Annnnya/talos_hack/CAD/CAD renders/Render1/images/panorama.png

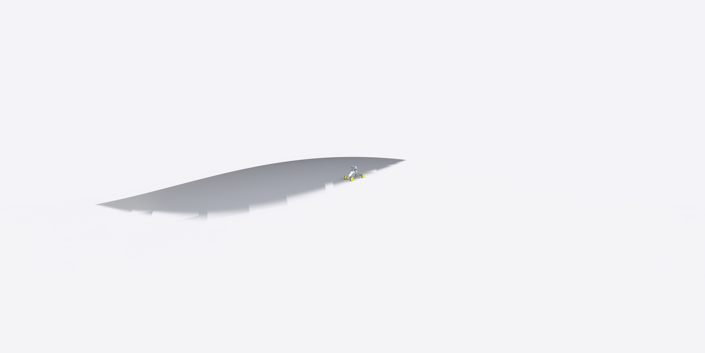
CAD/CAD renders/Render1/images/panorama.png
