Annnnya/talos_hack/CAD/CAD renders/render2.png

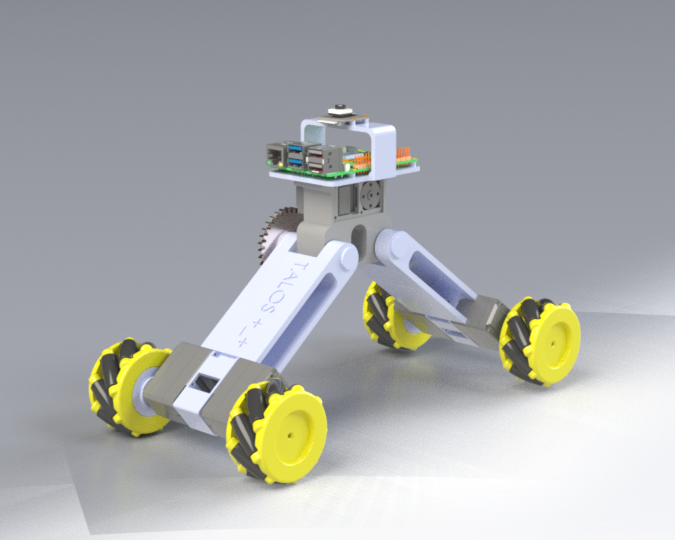
CAD/CAD renders/render2.png
