Annnnya/talos_hack/CAD/roue Mecanum.stp

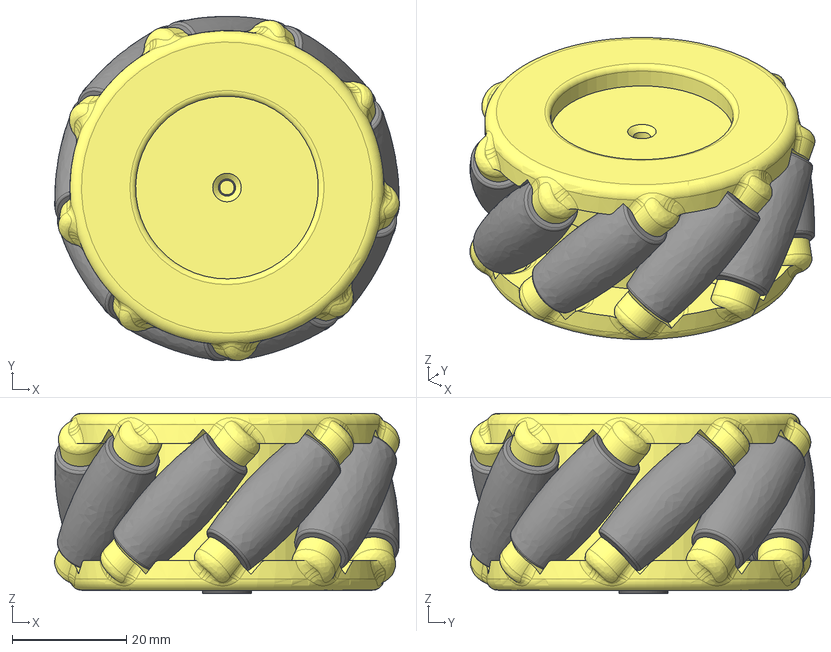
[picture p4: CAD file, 2026-10-20]
CAD/roue Mecanum.stp
60.4 x 60.3 x 31.6 mm
axes galet
galet x 9
adaptateur axe
axes galet flasque-01-02
axes galet flasque-01-01
