Annnnya/talos_hack/CAD/motor mounts.STEP

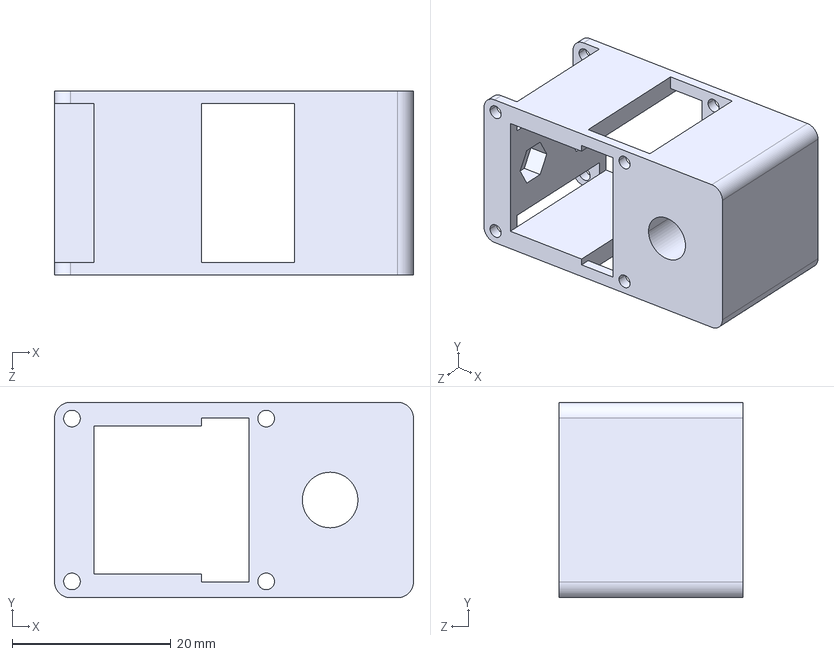
[picture p5: CAD file, 2026-10-20]
CAD/motor mounts.STEP
45.2 x 24.6 x 23.2 mm
