Annnnya/talos_hack/CAD/rpi mount.SLDPRT

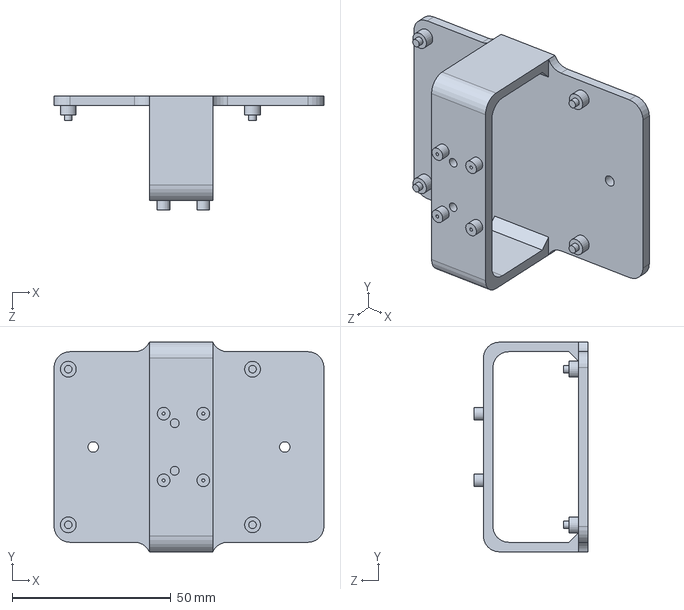
[picture p6: CAD file, 2026-10-20]
CAD/rpi mount.SLDPRT
85.0 x 66.0 x 36.0 mm
