Annnnya/talos_hack/CAD/spur gear.SLDPRT

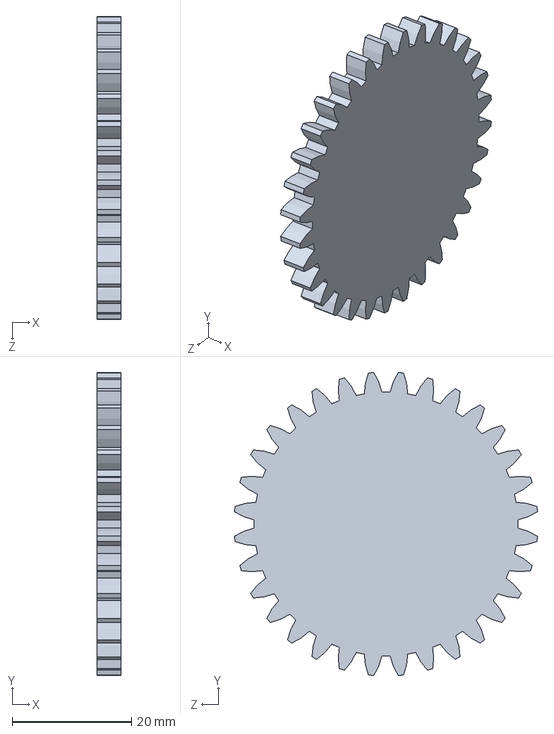
[picture p7: CAD file, 2026-10-20]
CAD/spur gear.SLDPRT
4.00 x 50.8 x 50.8 mm
