Annnnya/talos_hack/CAD/front plate.SLDPRT

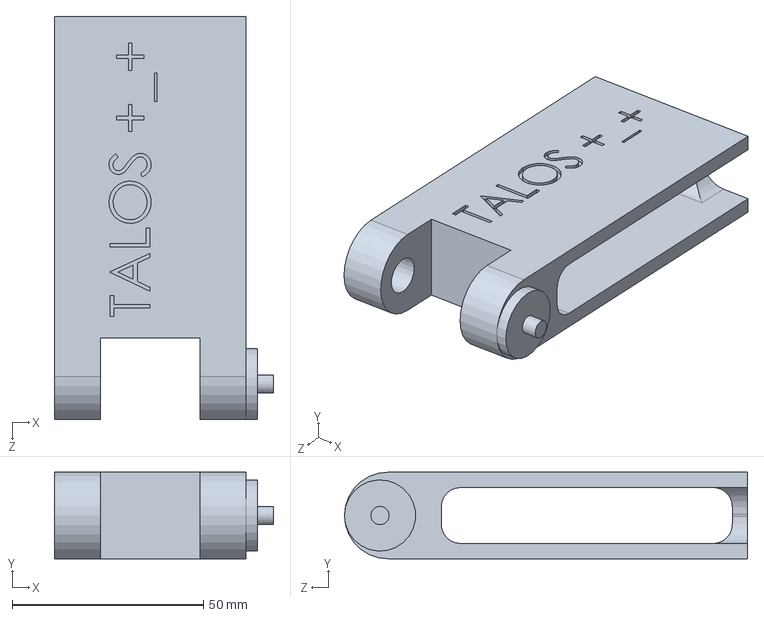
[picture p8: CAD file, 2026-10-20]
CAD/front plate.SLDPRT
57.2 x 22.6 x 105.3 mm
