Annnnya/talos_hack/CAD/Servo_enclosure_Servo_Enclosure.SLDPRT

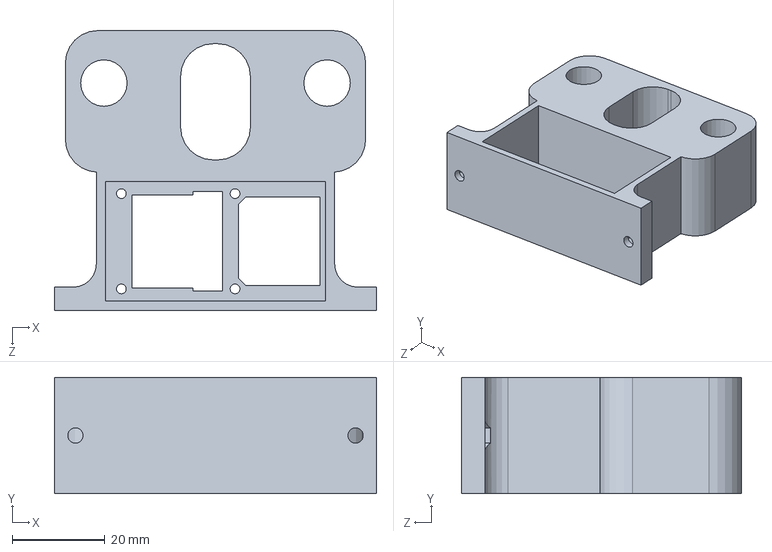
[picture p9: CAD file, 2026-10-20]
CAD/Servo_enclosure_Servo_Enclosure.SLDPRT
69.3 x 25.0 x 60.2 mm
