Annnnya/talos_hack/CAD/hinge pin.SLDPRT

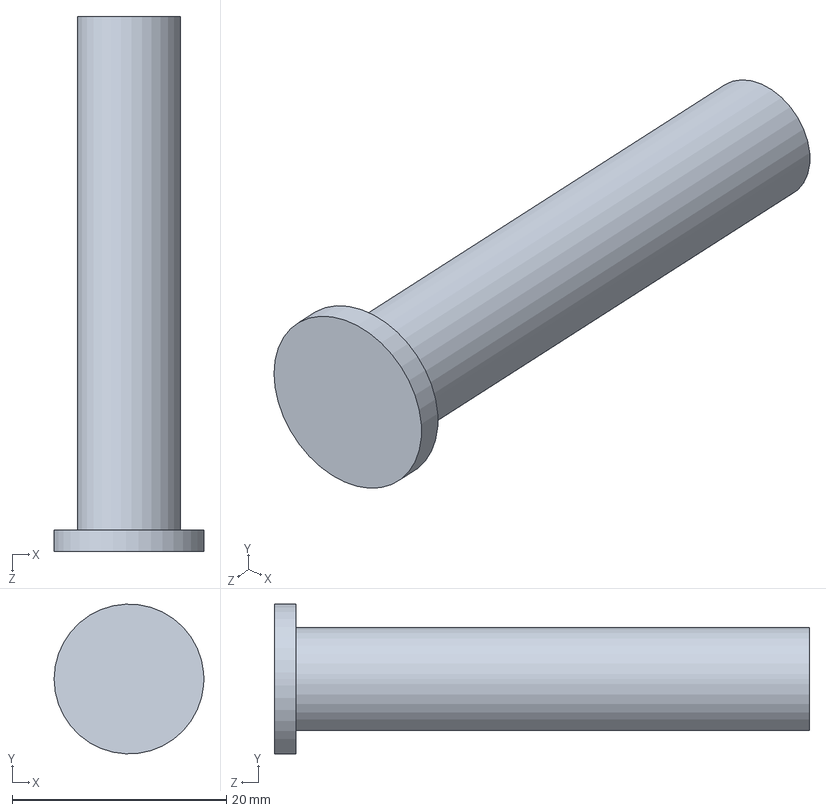
[picture p10: CAD file, 2026-10-20]
CAD/hinge pin.SLDPRT
14.0 x 14.0 x 50.0 mm
