Annnnya/talos_hack/CAD/middle body.STEP

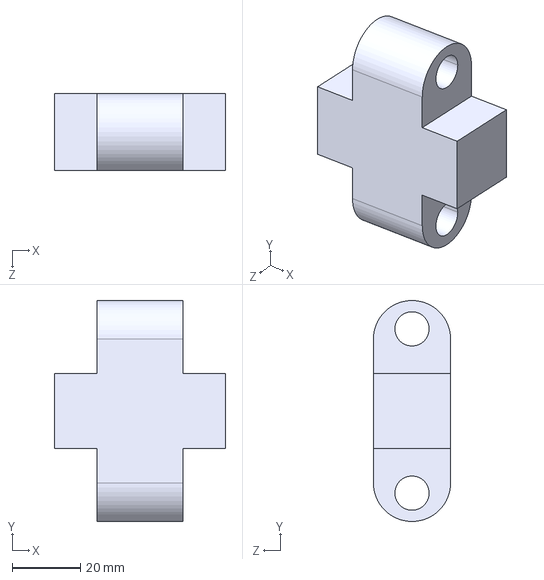
[picture p11: CAD file, 2026-10-20]
CAD/middle body.STEP
50.0 x 64.6 x 22.6 mm
