Annnnya/talos_hack/CAD/sevo mecanum hub.SLDPRT

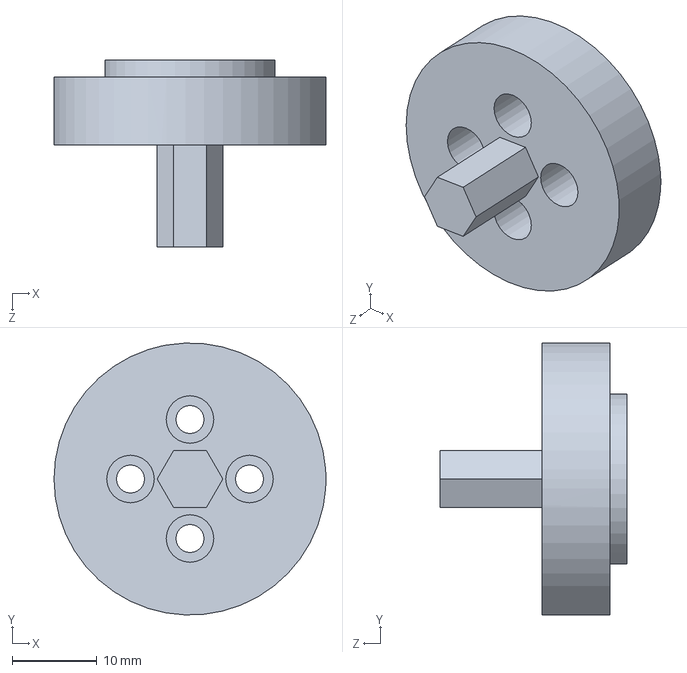
[picture p12: CAD file, 2026-10-20]
CAD/sevo mecanum hub.SLDPRT
32.0 x 32.0 x 22.0 mm
