Annnnya/talos_hack/CAD/main assembly.SLDASM

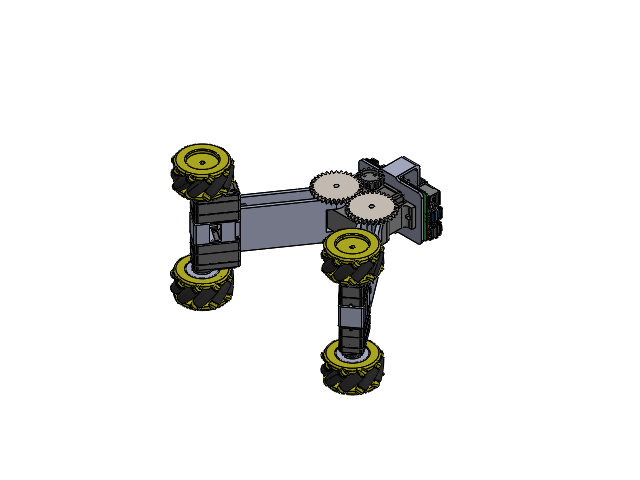
[picture p13: CAD file, 2026-10-20]
CAD/main assembly.SLDASM
ZK_122.stp x 5
SG-ZIJI_15.stp x 5
XG-ZIJI_16.stp x 5
MOTOR-1723_3.stp x 5
PCB-CHAZUO_92.stp x 5
GE_27.stp x 5
金属舵盘（驱动）.stp x 5
金属舵盘（从动）.stp x 5
sevo mecanum hub x 4
axes galet.stp x 4
galet.stp x 36
axes galet flasque-01-02.stp x 4
axes galet flasque-01-01.stp x 4
motor mounts x 2
front plate
Back plate
spur gear_am x 2
hinge pin x 2
Servo_gear (1).step
CARD_SLOT_METAL_PIN.STEP
SD_CARD_V1.STEP
PART3_V1.STEP
PLATE_RASPBERRY_PI_5.STEP
METAL_PLATE..STEP
GIGABIT_ETHERNET_PORT.STEP
2xUSB_3.0_PORT.STEP
2xUSB_2.0_PORT.STEP
FEMALE_MICRO_HDMI_CONNECTOR.STEP x 2
FEMALE_USB_CONNECTOR.STEP
STOCK_1.STEP
STOCK_2.STEP
STOCK_3.STEP
3.0_PIN_HEADER_10.STEP
2.0_PIN_HEADER.STEP
9FD77_D9WHV.STEP
GIGABIT_ETHERNET_TRANSCEIVER.STEP
RP1_CO_CONTROLLER.STEP
BROADCOM_1.STEP
MxL.STEP
CAMERA_DISPLAY_1.STEP
BUTTON_MINI.STEP
BUTTON_2.STEP
CONNECT_V1.STEP
CAMERA_DISPLAY_2.STEP x 2
Logo raspberry.STEP
Servo_enclosure_Servo_Enclosure
sfw15r3ste1lf.step
Rear Components-0.step
Rear Components-1.step
Rear Components-2.step
Rear Components-3.step
Rear Components-4.step
Sensor.step
Lens.step
Ring.step
Mount.step
Housing.step
Board.step
eBom-FreeParts_1.step
rpi mount
