Annnnya/talos_hack/CAD/ST3215 Servo.SLDASM

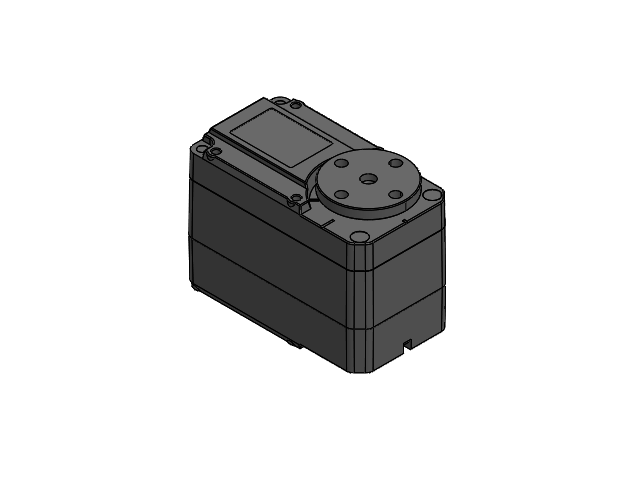
[picture p14: CAD file, 2026-10-20]
CAD/ST3215 Servo.SLDASM
ZK_122.stp
SG-ZIJI_15.stp
XG-ZIJI_16.stp
MOTOR-1723_3.stp
PCB-CHAZUO_92.stp
GE_27.stp
金属舵盘（驱动）.stp
