Annnnya/talos_hack/CAD/Wheel motor subassembly.SLDASM

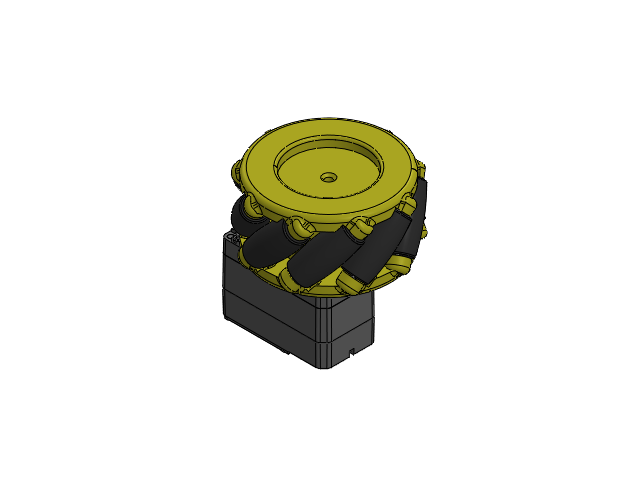
[picture p15: CAD file, 2026-10-20]
CAD/Wheel motor subassembly.SLDASM
ZK_122.stp
SG-ZIJI_15.stp
XG-ZIJI_16.stp
MOTOR-1723_3.stp
PCB-CHAZUO_92.stp
GE_27.stp
金属舵盘（驱动）.stp
sevo mecanum hub
axes galet.stp
galet.stp x 9
axes galet flasque-01-02.stp
axes galet flasque-01-01.stp
