Annnnya/talos_hack/(list of files, cad)

Other CAD files:
CAD/Back plate.SLDPRT
CAD/RASPBERRY_PI_5_1.STEP
CAD/spur gear_am.STL
CAD/Back plate.STL
CAD/Servo_enclosure_Servo_Enclosure.STL
CAD/front plate.STL
CAD/hinge pin.STL
CAD/middle body.SLDPRT
CAD/middle body.STL
CAD/motor mounts.SLDPRT
CAD/motor mounts.STL
CAD/roue Mecanum.SLDASM
CAD/rpi mount.STL
CAD/sevo mecanum hub.STL
CAD/spur gear.STL
