Annnnya/talos_hack/ros2_ws/src/talos_mecanum/config/robot.yaml

/talos_mecanum_drive:
  ros__parameters:
    baudrate: 1000000
    wheel_ids: [1, 2, 3, 4]
    wheel_directions: [1, 1, 1, 1]
    wheelbase_m: 0.3
    track_width_m: 0.3
    steps_per_meter: 1000.0
    max_speed: 100
    acceleration: 20
    max_linear_speed: 0.1
    max_angular_speed: 0.5
    joint_state_rate_hz: 10.0
    diagnostics_rate_hz: 1.0
