Annnnya/talos_hack/tests/test_config.py

from __future__ import annotations

import copy
import math
from pathlib import Path

import pytest
import yaml
from conftest import BASE, SMALL

from talos_servo.bend_calibration import (
    CALIBRATION_ENV_VAR,
    CALIBRATION_FILE,
    BendCalibration,
)
from talos_servo.config import (
    MODE_NAMES,
    ConfigError,
    ModesConfig,
    load_config,
    parse_config,
)
from talos_servo.modes import Mode

ROBOT_CONFIG = Path(__file__).parent.parent / "config" / "robot.yaml"


def with_changes(data: dict, **joint_changes: dict) -> dict:
    changed = copy.deepcopy(data)
    for joint, fields in joint_changes.items():
        changed["joints"][joint].update(fields)
    return changed


def test_joint_defaults():
    joint = parse_config(SMALL).joints[1]
    assert (joint.inverted, joint.enabled) == (False, True)
    assert (joint.min_pos, joint.max_pos) == (0, 4095)


@pytest.mark.parametrize(
    "data",
    [
        {"joints": {}},
        with_changes(SMALL, wheel={"id": 1}),
        with_changes(SMALL, bend={"min_pos": 3000, "max_pos": 1000}),
        with_changes(SMALL, wheel={"control": "wheel"}),
        with_changes(SMALL, wheel={"inverted": "yes"}),
        with_changes(SMALL, wheel={"id": 254}),
        {**SMALL, "max_speed": 0},
        {**SMALL, "control_hz": 0},
        {"joints": {"Front Left": {"id": 1, "control": "speed"}}},
        {"joints": {"wheel": {"id": 1}}},
    ],
)
def test_invalid_config_is_rejected(data):
    with pytest.raises(ConfigError):
        parse_config(data)


@pytest.mark.parametrize(
    ("change", "message"),
    [
        ({"wheels": ["fl", "fr", "rl"]}, "4 different joints"),
        ({"wheels": ["fl", "fr", "rl", "nope"]}, "not a joint"),
        ({"wheels": ["fl", "fr", "rl", "bend"]}, "enabled speed joint"),
        ({"wheelbase_m": -1}, "positive"),
    ],
)
def test_invalid_base_is_rejected(change, message):
    data = copy.deepcopy(BASE)
    data["base"].update(change)
    with pytest.raises(ConfigError, match=message):
        parse_config(data)


def test_base_is_optional():
    assert parse_config(SMALL).base is None


def test_modes_are_optional():
    assert parse_config(SMALL).modes is None


def test_modes_parse_controllers_per_mode():
    modes = parse_config(
        {
            **SMALL,
            "modes": {
                "controllers": {"free": ["drive"], "clamping": None},
                "switch_timeout_s": 1.5,
            },
        }
    ).modes
    assert modes is not None
    assert modes.for_mode("free") == ("drive",)
    assert modes.for_mode("clamping") == ()
    assert modes.for_mode("climbing") == ()
    assert modes.switch_timeout_s == 1.5


def test_mode_names_match_the_state_machine():
    assert set(MODE_NAMES) == {m.value for m in Mode}


def test_mode_controllers_are_read_only():
    modes = ModesConfig(controllers={"free": ("drive",)})
    with pytest.raises(TypeError):
        modes.controllers["free"] = ("wall",)  # type: ignore[index]
    assert modes.managed == {"drive"}


@pytest.mark.parametrize(
    ("modes", "message"),
    [
        ([], "mapping"),
        ({"controllers": ["drive"]}, "map a mode"),
        ({"controllers": {"flying": ["drive"]}}, "unknown modes"),
        ({"controllers": {"free": "drive"}}, "list of controller names"),
        ({"controllers": {"free": [""]}}, "list of controller names"),
        ({"switch_timeout_s": 0}, "positive"),
    ],
)
def test_invalid_modes_are_rejected(modes, message):
    with pytest.raises(ConfigError, match=message):
        parse_config({**SMALL, "modes": modes})


def test_repo_config_loads_modes():
    config = load_config(
        Path(__file__).resolve().parents[1] / "config" / "robot.yaml"
    )
    assert config.modes is not None
    assert config.modes.for_mode("free")


MODEL = {
    "hinge_joint": "bend",
    "leg_gear_ratio": 0.5,
    "bend_min_deg": 90,
    "bend_max_deg": 180,
}


def test_model_is_parsed():
    model = parse_config({**BASE, "model": MODEL}).model
    assert model.leg_length_m == 0.15
    assert model.bend_min_rad == pytest.approx(math.pi / 2)
    assert model.bend_max_rad == pytest.approx(math.pi)


def test_model_needs_a_base():
    with pytest.raises(ConfigError, match="base section"):
        parse_config({**SMALL, "model": MODEL})


def test_model_is_optional():
    assert parse_config(BASE).model is None


@pytest.mark.parametrize(
    ("change", "message"),
    [
        ({"bend_min_deg": 180}, "bend_min_deg < bend_max_deg"),
        ({"bend_max_deg": 200}, "bend_max_deg <= 180"),
        ({"leg_gear_ratio": 0}, "positive"),
        ({"hinge_joint": "nope"}, "hinge_joint"),
        ({"hinge_joint": "fl"}, "position joint"),
        ({"bend_flat_steps": 2048.5}, "whole step"),
        ({"bend_flat_steps": True}, "whole step"),
        # 90 deg of fold needs 1024 steps below flat.
        ({"bend_flat_steps": 1000}, "outside one servo turn"),
        ({"bend_flat_steps": 4096}, r"0\.\.4095"),
    ],
)
def test_invalid_model_is_rejected(change, message):
    with pytest.raises(ConfigError, match=message):
        parse_config({**BASE, "model": {**MODEL, **change}})


def hinge_data(bend: dict | None = None, **model_changes) -> dict:
    data = with_changes(BASE, bend={"enabled": True, **(bend or {})})
    return {**data, "model": {**MODEL, **model_changes}}


def bend_joint(data: dict):
    return next(j for j in parse_config(data).joints if j.name == "bend")


def test_enabled_hinge_needs_a_flat_position():
    with pytest.raises(ConfigError, match="bend_flat_steps is required"):
        parse_config(hinge_data())


def test_disabled_hinge_needs_no_flat_position():
    assert parse_config({**BASE, "model": MODEL}).hinge is None


def test_bend_limits_narrow_to_the_hinge_range():
    # 90 deg of fold is 1024 steps below flat (1:1 with the servo).
    joint = bend_joint(hinge_data(bend_flat_steps=4095))
    assert (joint.min_pos, joint.max_pos) == (3071, 4095)


def test_tighter_bend_limits_are_kept():
    data = hinge_data({"min_pos": 3500, "max_pos": 4000}, bend_flat_steps=4095)
    joint = bend_joint(data)
    assert (joint.min_pos, joint.max_pos) == (3500, 4000)


def test_bend_limits_outside_the_hinge_range_are_rejected():
    data = hinge_data({"min_pos": 0, "max_pos": 2000}, bend_flat_steps=4095)
    with pytest.raises(ConfigError, match="does not overlap"):
        parse_config(data)


def test_inverted_hinge_flat_is_a_raw_servo_position():
    # Raw 0 on an inverted servo is joint step 4095.
    data = hinge_data({"inverted": True}, bend_flat_steps=0)
    assert parse_config(data).hinge.flat_steps == 4095
    joint = bend_joint(data)
    assert (joint.min_pos, joint.max_pos) == (3071, 4095)


def test_repo_config_is_valid():
    config = load_config(ROBOT_CONFIG)
    assert config.model is not None
    assert config.base is not None


def test_repo_config_clamps_bend_to_the_hinge_range():
    config = load_config(ROBOT_CONFIG)
    hinge = config.hinge
    assert hinge is not None
    bend = next(j for j in config.joints if j.name == hinge.joint)
    assert (bend.min_pos, bend.max_pos) == hinge.step_range


def test_steps_per_meter_follow_the_wheel_radius():
    data = copy.deepcopy(BASE)
    data["base"]["wheel_radius_m"] = 0.03
    base = parse_config(data).base
    assert base.steps_per_meter == pytest.approx(4096 / (2 * math.pi * 0.03))


def test_wheel_radius_is_required():
    data = copy.deepcopy(BASE)
    del data["base"]["wheel_radius_m"]
    with pytest.raises(ConfigError, match="wheel_radius_m"):
        parse_config(data)


def test_modes_parse_hinge_motion_controllers():
    modes = parse_config(
        {
            **SMALL,
            "modes": {
                "controllers": {"free": ["drive"]},
                "hinge_motion": ["wheels"],
            },
        }
    ).modes
    assert modes is not None
    assert modes.hinge_motion == ("wheels",)
    assert modes.managed == {"drive", "wheels"}


def test_invalid_hinge_motion_is_rejected():
    with pytest.raises(ConfigError, match="hinge_motion"):
        parse_config({**SMALL, "modes": {"hinge_motion": "wheels"}})


def test_expansion_defaults_without_a_section():
    expansion = parse_config(SMALL).expansion
    assert 0 < expansion.max_rate_rad_s < 0.3
    assert expansion.command_timeout_s == 0.5


def test_expansion_is_parsed():
    expansion = parse_config(
        {**hinge_data(bend_flat_steps=4000), "expansion": {"rate_hz": 25}}
    ).expansion
    assert expansion.rate_hz == 25


def test_clamp_settings_are_parsed():
    expansion = parse_config(
        {
            **hinge_data(bend_flat_steps=4000),
            "expansion": {
                "clamp_rate_rad_s": 0.02,
                "hinge_contact_current_a": 1.2,
                "wheel_contact_current_a": 0.7,
                "contact_hold_s": 0.2,
                "contact_grace_s": 0.5,
            },
        }
    ).expansion
    assert (
        expansion.clamp_rate_rad_s,
        expansion.hinge_contact_current_a,
        expansion.wheel_contact_current_a,
        expansion.contact_hold_s,
        expansion.contact_grace_s,
    ) == (0.02, 1.2, 0.7, 0.2, 0.5)


def test_clamp_opens_slower_than_the_cap_by_default():
    expansion = parse_config(SMALL).expansion
    assert 0 < expansion.clamp_rate_rad_s <= expansion.max_rate_rad_s


@pytest.mark.parametrize(
    ("expansion", "message"),
    [
        ([], "mapping"),
        ({"max_rate_rad_s": 0}, "positive"),
        ({"max_lead_rad": -1}, "positive"),
        ({"hinge_contact_current_a": 0}, "positive"),
        ({"contact_grace_s": -0.1}, "positive"),
        ({"clamp_rate_rad_s": 0.2}, "must not exceed max_rate_rad_s"),
        # The bridge moves the hinge servo at about 0.31 rad/s.
        ({"max_rate_rad_s": 0.5}, "below the hinge servo speed"),
    ],
)
def test_invalid_expansion_is_rejected(expansion, message):
    data = {**hinge_data(bend_flat_steps=4000), "expansion": expansion}
    with pytest.raises(ConfigError, match=message):
        parse_config(data)


def test_repo_config_moves_the_hinge_in_clamping():
    config = load_config(ROBOT_CONFIG)
    assert config.modes is not None
    assert config.modes.hinge_motion
    assert set(config.modes.hinge_motion) <= set(
        config.modes.for_mode("clamping")
    )


def write_calibration(path: Path, flat: int, fold: int) -> Path:
    path.write_text(f"flat_steps: {flat}\nfold_steps: {fold}\n", "utf-8")
    return path


def write_robot(tmp_path: Path) -> Path:
    path = tmp_path / "robot.yaml"
    path.write_text(yaml.safe_dump(hinge_data(bend_flat_steps=4000)), "utf-8")
    return path


def test_without_calibration_the_model_values_apply(tmp_path, monkeypatch):
    monkeypatch.delenv(CALIBRATION_ENV_VAR, raising=False)
    config = load_config(write_robot(tmp_path))
    assert config.bend_calibration is None
    assert config.hinge.flat_steps == 4000
    assert config.model.bend_min_deg == 90


def test_calibration_next_to_the_config_overrides_the_model(
    tmp_path, monkeypatch
):
    monkeypatch.delenv(CALIBRATION_ENV_VAR, raising=False)
    robot = write_robot(tmp_path)
    write_calibration(tmp_path / CALIBRATION_FILE, 3900, 3000)
    config = load_config(robot)
    assert config.bend_calibration == BendCalibration(3900, 3000)
    assert config.hinge.flat_steps == 3900
    assert config.model.bend_min_deg == pytest.approx(180 - 900 * 360 / 4096)
    assert config.hinge.step_range == (3000, 3900)
    bend = next(j for j in config.joints if j.name == "bend")
    assert (bend.min_pos, bend.max_pos) == (3000, 3900)


def test_explicit_calibration_path_wins(tmp_path, monkeypatch):
    monkeypatch.delenv(CALIBRATION_ENV_VAR, raising=False)
    robot = write_robot(tmp_path)
    write_calibration(tmp_path / CALIBRATION_FILE, 3900, 3000)
    other = write_calibration(tmp_path / "other.yaml", 3800, 2900)
    assert load_config(robot, other).hinge.flat_steps == 3800


def test_invalid_calibration_names_the_file(tmp_path, monkeypatch):
    monkeypatch.delenv(CALIBRATION_ENV_VAR, raising=False)
    robot = write_robot(tmp_path)
    write_calibration(tmp_path / CALIBRATION_FILE, 3000, 3500)
    with pytest.raises(ConfigError, match=f"{CALIBRATION_FILE}.*Delete"):
        load_config(robot)


def test_calibration_needs_a_model():
    with pytest.raises(ConfigError, match="model section"):
        parse_config(BASE, BendCalibration(4000, 3000))


def test_broken_yaml_is_a_config_error(tmp_path):
    path = tmp_path / "robot.yaml"
    path.write_text("joints: [unclosed", "utf-8")
    with pytest.raises(ConfigError, match="not valid YAML"):
        load_config(path)


# --- imu mount (#91) ------------------------------------------------------


def test_imu_mount_defaults_to_zeros():
    imu = parse_config(SMALL).imu
    assert (imu.xyz, imu.rpy) == ((0.0, 0.0, 0.0), (0.0, 0.0, 0.0))


def test_imu_mount_is_parsed():
    data = {**SMALL, "imu": {"xyz": [0.01, 0, 0.05], "rpy": [0, 0, 1.5708]}}
    imu = parse_config(data).imu
    assert imu.xyz == (0.01, 0.0, 0.05)
    assert imu.rpy == (0.0, 0.0, 1.5708)


def test_imu_mount_keys_are_optional():
    imu = parse_config({**SMALL, "imu": {"rpy": [0.1, 0, 0]}}).imu
    assert (imu.xyz, imu.rpy) == ((0.0, 0.0, 0.0), (0.1, 0.0, 0.0))


@pytest.mark.parametrize(
    ("imu", "message"),
    [
        ([0, 0, 0], "mapping"),
        ({"xyz": [0, 0]}, "three numbers"),
        ({"rpy": "flat"}, "three numbers"),
        ({"xyz": [0, "a", 0]}, "three numbers"),
        ({"rpy": [0, math.inf, 0]}, "finite"),
    ],
)
def test_invalid_imu_mount_is_rejected(imu, message):
    with pytest.raises(ConfigError, match=message):
        parse_config({**SMALL, "imu": imu})


def test_repo_config_mounts_the_imu_chip_down():
    # The board is screwed on upside down (#91); the URDF reads the same.
    imu = load_config(ROBOT_CONFIG).imu
    assert imu.xyz == (0.0, 0.0, 0.0)
    assert imu.rpy == pytest.approx((math.pi, 0.0, 0.0))
