Annnnya/talos_hack/(commit log)

2026-10-17 some servo tests
2026-10-17 refactor: turn servo test scripts into a tested python package and cli (#4)
    * some servo tests
    * chore: add gitignore for python, uv and worktrees
    * docs: add shared agent rulebook with pr-based workflow
    * docs: add claude code instructions importing agents rules
    * chore: add uv project using the official feetech sdk
    * feat: add servo bus wrapper that checks results and always stops servos
    * feat: replace hardcoded test scripts with talos-servo cli
    * test: cover servo bus and cli with a fake sdk
    * chore: add ci workflow running ruff and pytest
    * docs: document setup, cli usage and development commands
    * feat: add set-id command replacing the change_ids script
    * test: cover set-id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
2026-10-17 feat: web ui for servo position and speed control (#8)
    * feat: add web ui and bridge for servo position and speed control
    * docs: name ros 2 node files with a _node suffix
    * feat: add position mode, move and status reads to servo bus
    * chore: add web extra to uv and pixi
    * feat: move web bridge into talos_servo package as web command
    * fix: lower default ui speeds and never send speed 0 moves
    * chore: build web ui in ci
    * docs: document web ui command
2026-10-17 ai generated attempt to control mechanum wheels
2026-10-17 feat: raise web ui speed cap to servo rated max (#12)
2026-10-17 feat: ros 2 node for the servo bus (#10)
2026-10-17 feat: mpu6050 imu driver and cli command (#16)
2026-10-17 feat: publish wheel servo readouts as ros topics (#21)
    * feat: add wheel telemetry helpers for encoder unwrapping and unit conversion
    * chore: add sensor_msgs and diagnostic_msgs ros dependencies
    * feat: publish wheel joint states and servo diagnostics from the drive node
    * docs: document wheel readout topics in the ros section
2026-10-17 feat: read present current and moving flag from servos (#27)
    * feat: read present current and moving flag in the servo bus
    * feat: report current and moving in web state and ros diagnostics
2026-10-17 feat: publish per joint numeric readout topics (#28)
    * chore: add std_msgs ros dependency for readout topics
    * feat: publish per joint numeric readout topics from both ros nodes
2026-10-17 feat: publish mpu6050 imu data as ros topics (#37)
    * feat: add imu ros node that publishes raw accel and gyro
    * chore: add madgwick filter task for imu orientation
    * docs: document the imu ros topics in the readme
2026-10-17 feat: let the web ui drive the servos through the ros servo bridge (#39)
    * feat: let the web ui drive the servos through the ros servo bridge
    * test: cover the ros web backend against a simulated servo bridge
    * docs: describe the web ui over ros and update the architecture diagrams
    * test: keep the ros web backend tests off any real servo bridge
2026-10-17 feat: let cli spin and monitor drive servos through the ros servo bridge (#43)
    * feat: let cli spin and monitor drive servos through the ros servo bridge
    * test: cover cli spin and monitor over ros against a simulated bridge
    * docs: explain cli commands next to the web ui and add them to the diagram
    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
2026-10-17 chore: start the servo bridge on boot and run the web ui through it (#45)
    * chore: start the servo bridge on boot and run the web ui through it
    * docs: explain installing the bridge and web ui boot services
2026-10-17 feat: add robot_localization ekf for the base pose (#47)
    * chore: add robot_localization ekf config and tasks
    * test: check ekf sensor config layout
    * docs: document the ekf pose estimate
2026-10-17 feat: show the last command from any source on the web ui sliders (#49)
    * feat: track who sent each servo command and report it from the bridge
    * feat: give each browser a client id and share move settings across browsers
    * test: cover command attribution, shared settings and watchdog ownership
    * feat: show who last commanded each servo and follow it on the sliders
    * docs: explain the last command caption and shared move settings
    * test: let the move stub accept the command source arguments
2026-10-17 perf: drive mecanum wheels in sync from one control loop (#50)
    * perf: add sync write to set several servo speeds in one packet
    * feat: scale wheel acceleration so all wheels finish ramping together
    * perf: read servo position, speed and status in one block read
    * feat: add mecanum control loop that writes all wheels before reading telemetry
    * perf: drive mecanum wheels from one control loop so commands never wait on reads
    * fix: refuse to open a servo port another process already holds
    * docs: describe the mecanum control loop and single port owner
2026-10-17 refactor: move shared servo core out of the web package (#51)
    * refactor: move config, controller and sim out of the web package
    * refactor: move shared defaults and arg parsers out of the cli
    * refactor: rename config/web.yaml to config/robot.yaml
    * refactor: rename WebConfig to RobotConfig
    * refactor: rename keyboard_teleop to keyboard_teleop_node
    * docs: point readme at the moved config, controller and sim modules
2026-10-17 refactor: one robot core, one node, one cli (#55)
    * refactor: replace controller and mecanum drive with one robot core and joint config
    * refactor: merge servo bridge and drive node into one robot node with wheel odometry
    * refactor: drive web ui joints by name with a fixed control mode
    * feat: add talos-servo drive for keyboard driving with or without ros
    * chore: run the robot node as talos-robot and drop colcon
    * style: format code at 80 characters per line
    * style: wrap comments, docstrings and strings at 80 characters
    * docs: rewrite readme around the two-layer architecture and one diagram set
2026-10-17 fix: main ci after the robot config edit, and readme ros commands (#57)
    * docs: add ros command examples to the readme
    * fix: check config structure instead of servo ids so wiring edits keep ci green
    * docs: show the real servo ids and base size in the readme
    * test: drop the repo config test, the config follows the real wiring
2026-10-17 fix: keep the servo port lock and recover the bus after a serial error (#59)
    * fix: keep the servo port lock and free the bus after a serial error
    * fix: log a stuck wheel write error once instead of every tick
2026-10-18 feat: move the per-motor web ui to /debug (#100)
2026-10-18 feat: robot model with bend hinge, mecanum wheels and wheelbase helper (#101)
2026-10-18 camera node
2026-10-18 docs: wheel kinematics for opening and closing the hinge (#104)
    * docs: derive wheel speeds for opening and closing the hinge
    * test: add hinge wheel speed test vectors checked against the wheelbase
    * fix: add the leg turn to the hinge wheel speeds since the wheel servos sit on the legs
2026-10-18 feat: mode-aware keyboard controller with a wall nearby key (#107)
    * feat: add mode-aware key filtering, action keys and a status line to the drive loop
    * feat: follow the robot mode and call wall nearby and release from the ros backend
    * feat: drive the keyboard controller through twist_mux with wall nearby and release keys
    * docs: describe the mode-aware keyboard controller
    * test: drive the keyboard tests on the base config now that drive needs a base
    * feat: turn stop on with space and release it with enter, with mode node calls off the key loop
    * docs: describe stop and release stop from the keyboard
2026-10-18 fix: camera node merge left ci red on main (#113)
    * style: wrap camera node to 80 columns
    * fix: drop unused colcon deps so pixi.lock matches the workspace
2026-10-18 feat: wall nearby button and mode-aware joystick (#117)
    * feat: joystick cross page for mobile and desktop
    * feat: report robot mode and accept wall nearby on the web server
    * feat: wall nearby button and mode-aware joystick
2026-10-18 feat: feetech hardware interface with the bend hinge in ros2_control (#109)
    * feat: convert the hinge opening angle to bend servo steps
    * feat: add the bend hinge to ros2_control with a launch for the whole robot
    * feat: drive the hinge in alpha from the hardware bridge and ignore the startup goal
    * docs: describe the hinge interfaces and the whole robot bench check
    * fix: require the fixed hinge flat position and clamp bend to the hinge range
    * fix: arm position joints on a new goal and report an unknown hinge angle as nan
    * docs: describe the fixed hinge flat position and the startup guard
    * refactor: share the inverted position helper and build the hinge once on load
    * fix: rearm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
2026-10-18 fix: stream the camera into rviz (#121)
    * fix: subscribe rviz to the compressed camera topics
    * fix: install compressed image transport in the viz environment
    * feat: start the camera stream on launch and show rpicam-vid errors
    * fix: add the camera optical frame to the robot model
    * docs: describe camera stream on start and rviz decoding
2026-10-18 feat: one per-mode drive rule for the keyboard and the web server (#119)
    * feat: one per-mode drive rule for the keyboard and the web server
    * refactor: build the joystick buttons per mode from the shared drive axes
2026-10-18 feat: drive the base with mecanum_drive_controller (#128)
    * refactor: drive with twist stamped through twist_mux
    * feat: mecanum drive controller for the base
    * feat: let the bridge drive base wheels past the joint speed cap
    * feat: serve the web server's status from the hardware bridge
    * feat: launch the base through ros2_control by default
    * chore: add a twist-mux task that feeds the mecanum controller
    * docs: mecanum drive controller and stamped twists
    * perf: read every wheel each tick for fresh odometry
2026-10-18 docs: restore mpu6050 wiring table (#132)
2026-10-18 feat: open and close the hinge with the wheels rolling along (#133)
    * feat: step the hinge goal and wheel speeds to open and close the hinge
    * feat: let the mode node hand the wheels to the hinge in free mode
    * feat: add the expansion node that opens and closes the hinge with the wheels
    * docs: describe opening and closing the hinge with the expansion node
2026-10-18 feat: brake wheels and hold the hinge on deactivate, error and shutdown (#129)
    * feat: brake the wheels and latch the safe state on servo bus faults
    * feat: log the safe state in the hardware bridge and test deactivate, error and shutdown
    * docs: describe the safe state in the ros2_control doc
    * test: show a failed wheel sync read does not latch the safe state
    * docs: explain why wheel sync reads do not latch the safe state
2026-10-18 feat: open and close the hinge with the r and f keys (#134)
    * feat: open and close the hinge with the r and f keys
    * docs: describe the r and f hinge keys
    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
2026-10-18 feat: wall climbing from the web page with hinge calibration and current hold (#144)
    Hinge panel, climb and sideways moves on the wall, speed slider, hinge current hold, servo overload handling, measured hinge calibration and 0.3 m/s caps.
2026-10-18 feat: calibrate the bend hinge flat and max fold (#136)
    * feat: bend calibration points, file and session in the core
    * feat: calibrate the bend hinge through the bridge with talos-servo calibrate-bend
    * feat: use the calibrated max fold as the urdf bend limit
    * docs: describe the bend calibration and ignore its file
    * fix: refuse a bend calibration save when the hinge servo changed since start
    * fix: answer bend calibration save errors instead of crashing the bridge
    * fix: reverse the bend jog from the hinge and save against the startup config
    * chore: commit the live-measured bend calibration as config/bend_calibration.yaml
2026-10-18 feat: open the hinge until the wheels press on both walls (#137)
    * feat: detect wall contact from hinge and wheel current while clamping
    * feat: add wall contact and no wall services to the mode node
    * feat: open the hinge by itself in clamping until the walls are touched
    * docs: describe clamping onto the walls
    * fix: answer bend calibration save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
2026-10-18 feat: imu mount from the config, platform tilt on the page and a no-argument launch (#145)
    * feat: read the imu mount from the robot config in the urdf
    * feat: show the platform roll and pitch from the imu on the joystick page
    * feat: start the imu chain by default and find the servo port without arguments
    * docs: launch command at the top of the readme and where the imu sits
    * chore: the imu is mounted chip-down, roll it half a turn in the config
2026-10-18 feat: show the ceiling camera on the web page (#148)
    * feat: keep the latest camera frame in the ros backend
    * feat: serve the latest camera frame as a jpeg
    * feat: show the camera on the joystick page at 2 fps
2026-10-20 Added CAD files and renders
